slaattnes/Biosignal-DAQ/biosignal-daq-v1.0-bottom.png

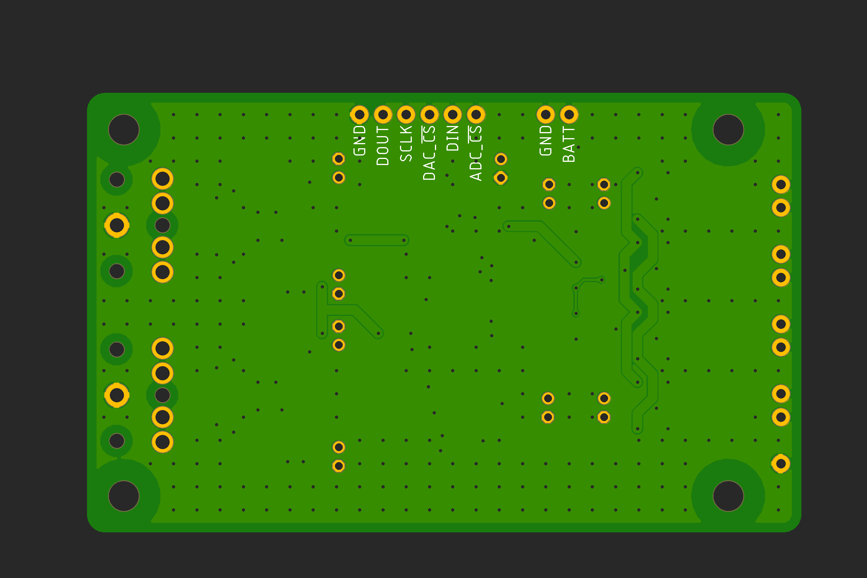
biosignal-daq-v1.0-bottom.png
