slaattnes/Biosignal-DAQ/biosignal-daq-v1.0-top.png

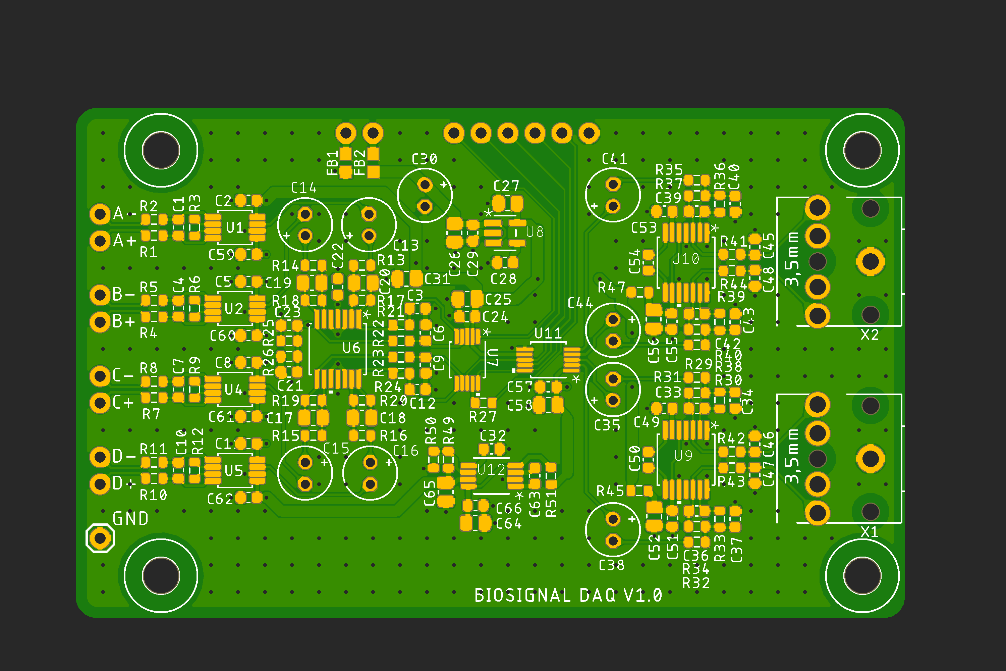
biosignal-daq-v1.0-top.png
