slaattnes/Biosignal-DAQ/biosignal-daq-v1.0-bom.xlsx

Qty | Value | Device | Package | Parts | MANUFACTURER_PART_NUMBER | RATING | TECHNOLOGY | TOLERANCE | VENDOR
10 | 10N | C0603 | CAPC160X80X91L36N | C1, C3, C4, C6, C7, C9, C10, C12, C28, C29 | MC0603B103K101CT | 100 V | X7R | 10% | Multicomp
9 | 100U | CPOL-EUE2-5 | E2-5 | C13, C14, C15, C16, C30, C35, C38, C41, C44 | UKW1C101MDD | 16 V |  | 20% | Nichicon
4 | 47N | C0805 | CAPC200X125X80L50N | C17, C18, C19, C20 | C0805C473K3GAC7800 | 25 V | C0G | 10% | KEMET
11 | 100N | C0603 | CAPC160X80X91L36N | C2, C5, C8, C11, C22, C24, C57, C59, C60, C61, C62 | MC0603B104K100CT | 10V | X7R | 10% | Multicomp
11 | 1U | C0603 | CAPC160X80X91L36N | C21, C23, C32, C49, C50, C51, C53, C54, C55, C63, C66 | 885012106010 | 10 V | X5R | 20% | Würth
9 | 10U | C0805 | CAPC200X125X80L50N | C25, C26, C27, C31, C52, C56, C58, C64, C65 | MCTT21X106M6R3CT | 6.3 V | X5R | 20% | Multicomp
4 | 100P | C0603 | CAPC160X80X91L36N | C33, C36, C39, C42 | MC0603N101J101CT | 100 V | C0G | 5% | Multicomp
4 | 560P | C0603 | CAPC160X80X91L36N | C34, C37, C40, C43 | 0603N561J500CT | 50 V | C0G | 5% | Walsin
4 | 33P | C0603 | CAPC160X80X91L36N | C45, C46, C47, C48 | 0603N330J250CT | 25 V | C0G | 5% | Walsin
2 | 30Œ©/1.8A | FERRITE_BEAD-0603 | 603 | FB1, FB2 | BLM18AG102SN1D |  |  |  | Murata
8 | 4K7 | R0603 | RESC160X80X55L25N | R1, R2, R4, R5, R7, R8, R10, R11 | MCWR06X4701FTL | 100mW |  | 1% | Multicomp
8 | 20K | R0603 | RESC160X80X55L25N | R13, R14, R15, R16, R29, R32, R35, R38 | MCWR06X2002FTL | 100 mW |  | 1% | Multicomp
4 | 360K | R0603 | RESC160X80X55L25N | R17, R18, R19, R20 | MCWR06X3603FTL | 100 mW |  | 1% | Multicomp
4 | 200R | R0603 | RESC160X80X55L25N | R21, R22, R23, R24 | MCWR06X2000FTL | 100 mW |  | 1% | Multicomp
4 | 200K | R0603 | RESC160X80X55L25N | R25, R26, R49, R50 | MCMR06X2003FTL | 100 mW |  | 1% | Multicomp
5 | 47R | R0603 | RESC160X80X55L25N | R27, R41, R42, R43, R44 | MCWR06X47R0FTL | 100 mW |  | 1% | Multicomp
4 | 24K | R0603 | RESC160X80X55L25N | R3, R6, R9, R12 | MCWR06X2402FTL | 100 mW |  | 1% | Multicomp
4 | 5K49 | R0603 | RESC160X80X55L25N | R30, R33, R36, R39 | MCMR06X5491FTL | 100 mW |  | 1% | Multicomp
4 | 28K | R0603 | RESC160X80X55L25N | R31, R34, R37, R40 | MCMR06X2802FTL | 100 mW |  | 1% | Multicomp
3 | 4R7 | R0603 | RESC160X80X55L25N | R45, R47, R51 | MCWR06W4R70FTL | 100 mW |  | 1% | Multicomp
4 | AD8226 | AD8226 | SOP8P65_300X490X95L60X32N | U1, U2, U4, U5 | AD8226ARMZ |  |  |  | Analog Devices
1 | DAC124S085_DGS_10 | DAC124S085_DGS_10 | MUB10A | U11 | DAC124S085_DGS_10 |  |  |  | Texas Instruments
1 | LM2687MM | LM2687MM | MUA08A | U12 | LM2687MM |  |  |  | Texas Instruments
1 | OPA4314 | OPA4314 | PW14 | U6 | OPA4314AIPWR |  |  |  | Texas Instruments
1 | ADC124S021CIMM | ADC124S021CIMM | MUB10A | U7 | ADC124S021CIMM |  |  |  | Texas Instruments
1 | LP2985-33DBVR | LP2985-33DBVR | DBV5 | U8 | LP298533DBVR |  |  |  | Texas Instruments
2 | DRV632PWR | DRV632PWR | PW14 | U9, U10 | DRV632PWR |  |  |  | Texas Instruments
2 | STEREOJACK | STEREOJACK | STX3100 | X1, X2 | SJ1-3555NG |  |  |  | CUI
129
