slaattnes/Biosignal-DAQ/biosignal-daq-v1.0-seeedfusion-bom.xlsx

Designator | MPN/Seeed SKU | Qty | Link
C1, C3, C4, C6, C7, C9, C10, C12, C28, C29 | 0603B103K101CT | 10 | http://file.elecfans.com/web1/M00/85/45/o4YBAFxuX5eAOrDGABKuxiKjpIQ835.pdf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
C17, C18, C19, C20 | C0805C473K3GAC7800 | 4 | https://www.mouser.se/ProductDetail/KEMET/C0805C473K3GAC7800?qs=5BlHYZRUXHFWU0inEjwM1Q==
C2, C5, C8, C11, C22, C24, C57, C59, C60, C61, C62 | 0603B104K160CT | 11 | http://file.elecfans.com/web1/M00/85/45/o4YBAFxuX5eAOrDGABKuxiKjpIQ835.pdf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
C21, C23, C32, C49, C50, C51, C53, C54, C55, C63, C66 | CL10B105KP8NNNC | 11 | http://file.elecfans.com/web1/M00/5C/4C/o4YBAFt04FWAbe4gAAKwH_HJHDI122.pdf
C25, C26, C27, C31, C52, C56, C58, C64, C65 | CL21B106KQQNNNE | 9 | http://www.samsungsem.com/kr/front/downloadcms.do?fileName=C_CL21B106KQQNNNE.pdf
C33, C36, C39, C42 | MC0603N101J101CT | 4 | https://uk.farnell.com/multicomp/mc0603n101j101ct/cap-mlcc-c0g-np0-100pf-100v-0603/dp/1759130
C34, C37, C40, C43 | 0603N561J500CT | 4 | https://www.digikey.com/product-detail/en/walsin-technology-corporation/0603N561J500CT/1292-1536-1-ND/9355540
C45, C46, C47, C48 | 0603N330J250CT | 4 | https://uk.farnell.com/walsin/0603n330j250ct/cap-33pf-25v-5-c0g-np0-0603-reel/dp/2521562
FB1, FB2 | BLM18AG102SN1D | 2 | https://www.digikey.com/product-detail/en/murata-electronics-north-america/BLM18AG102SN1D/490-1015-1-ND/584463
R1, R2, R4, R5, R7, R8, R10, R11 | PTFR0603B4K70P9 | 8 | http://file.elecfans.com/web1/M00/85/7D/o4YBAFxzUSqAb9xOABYkQrSS0nk266.pdf?filename=PTFR.pdf
R13, R14, R15, R16, R29, R32, R35, R38 | RC0603FR-0720KL | 8 | http://www.yageo.com.tw/exep/pages/download/literatures/PYu-R_INT-thick_7.pdf
R17, R18, R19, R20 | RC0603FR-07360KL | 4 | http://www.yageo.com/documents/recent/PYu-RC0603_51_RoHS_L_4.pdf
R21, R22, R23, R24 | PTFR0603B200RP9 | 4 | http://file.elecfans.com/web1/M00/85/7D/o4YBAFxzUSqAb9xOABYkQrSS0nk266.pdf?filename=PTFR.pdf
R25, R26, R49, R50 | PTFR0603B200KP9 | 4 | http://file.elecfans.com/web1/M00/85/7D/o4YBAFxzUSqAb9xOABYkQrSS0nk266.pdf?filename=PTFR.pdf
R27, R41, R42, R43, R44 | PTFR0603B47R0P9 | 5 | http://file.elecfans.com/web1/M00/85/7D/o4YBAFxzUSqAb9xOABYkQrSS0nk266.pdf?filename=PTFR.pdf
R3, R6, R9, R12 | RC0603FR-0724KL | 4 | http://www.yageo.com/documents/recent/PYu-RC0603_51_RoHS_L_4.pdf
R30, R33, R36, R39 | RC0603FR-075K49L | 4 | http://www.yageo.com/documents/recent/PYu-RC0603_51_RoHS_L_4.pdf
R31, R34, R37, R40 | 0603WAF2802T5E | 4 | http://file.elecfans.com/web1/M00/61/0C/o4YBAFt-dwWACUP4AAh1Wgzv73Y460.pdf
R45, R47, R51 | RC0603FR-074R7L | 3 | http://www.yageo.com/documents/recent/PYu-RC_Group_51_RoHS_L_9.pdf
U1, U2, U4, U5 | AD8226ARMZ | 4 | https://www.mouser.se/ProductDetail/Analog-Devices/AD8226ARMZ?qs=%2FtpEQrCGXCzt4qnwBCHKiA==
U11 | DAC124S085CIMM | 1 | https://www.mouser.se/ProductDetail/Texas-Instruments/DAC124S085CIMM-NOPB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
U12 | LM2687MM | 1 | https://www.mouser.se/ProductDetail/Texas-Instruments/LM2687MM-NOPB?qs=X1J7HmVL2ZEsc0DgTZ3C6g==
U6 | OPA4314AIPWR | 1 | https://www.mouser.se/ProductDetail/Texas-Instruments/OPA4314AIPWR?qs=2UFnnMkojnUj9oGVDYRMzw==
U7 | ADC124S021CIMM | 1 | https://www.mouser.se/ProductDetail/Texas-Instruments/ADC124S021CIMM-NOPB?qs=7X5t%252BdzoRHCsOQY55StpJg==
U8 | LP298533DBVR | 1 | https://www.mouser.se/ProductDetail/Texas-Instruments/LP2985-33DBVR
U9, U10 | DRV632PWR | 2 | https://www.mouser.se/ProductDetail/Texas-Instruments/DRV632PWR?qs=TeC8nwD7mVrHDYJBV6Ovjg==
