slaattnes/Biosignal-DAQ/biosignal-daq-v1.0-assembly-bottom.pdf

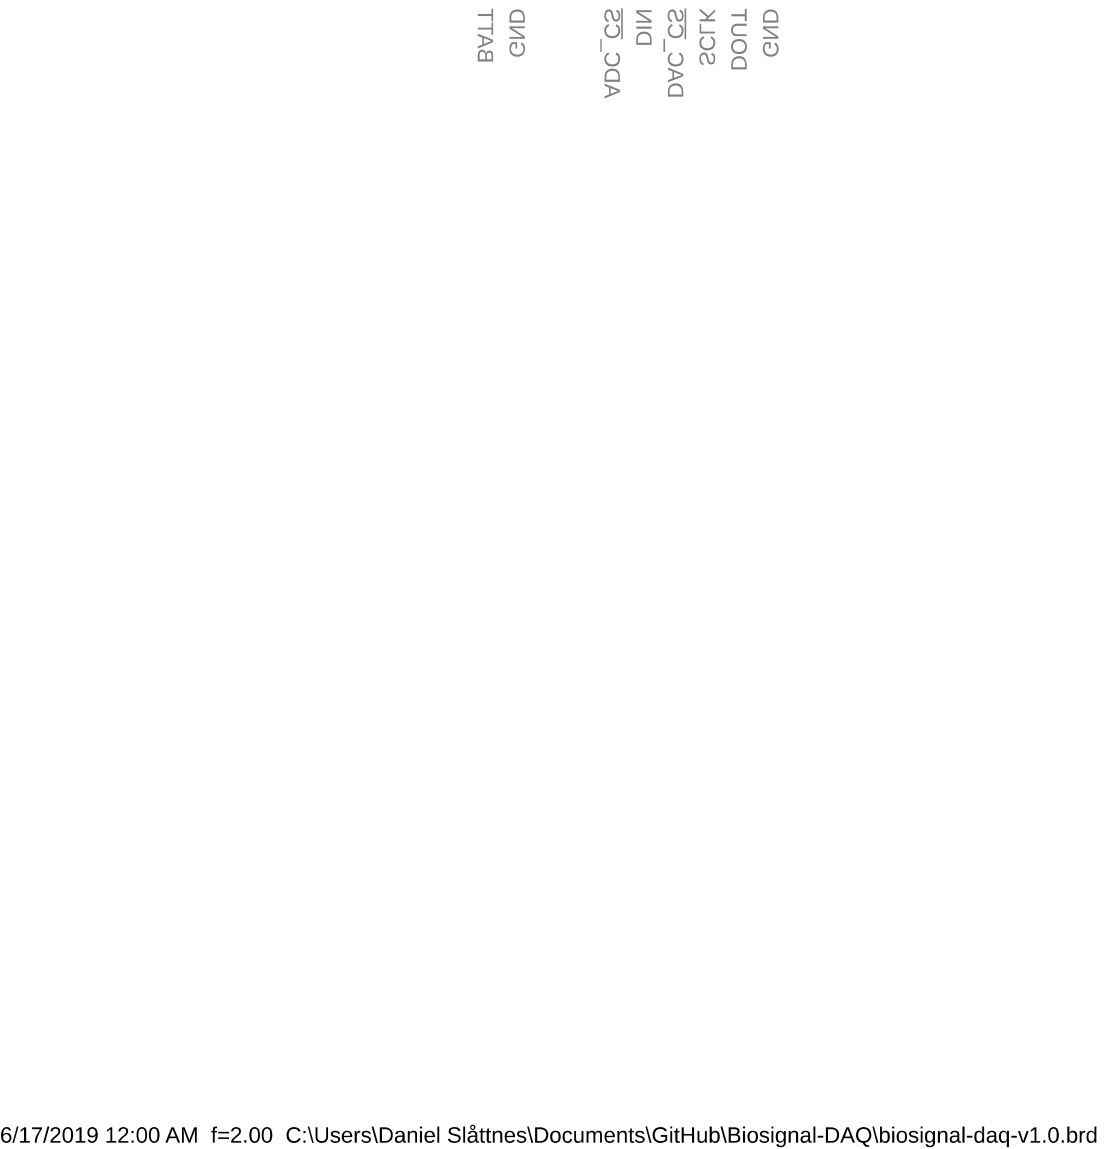
[picture p3: page 1]
