slaattnes/Biosignal-DAQ/biosignal-daq-v1.0-assembly-top.pdf

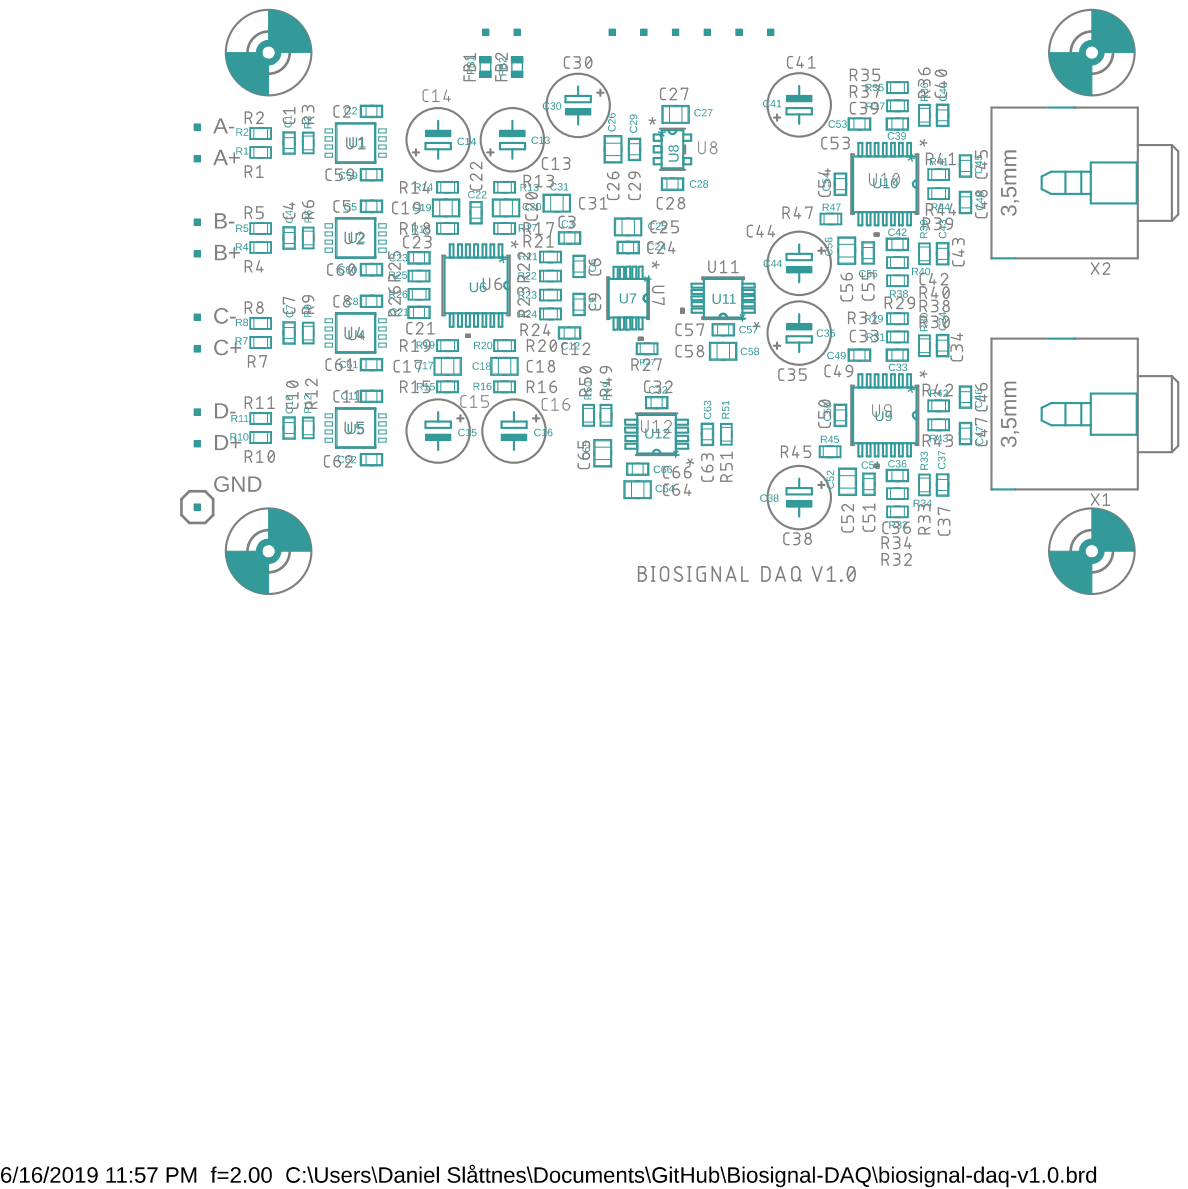
[picture p4: page 1]
