slaattnes/Biosignal-DAQ/biosignal-daq-v1.0.pdf

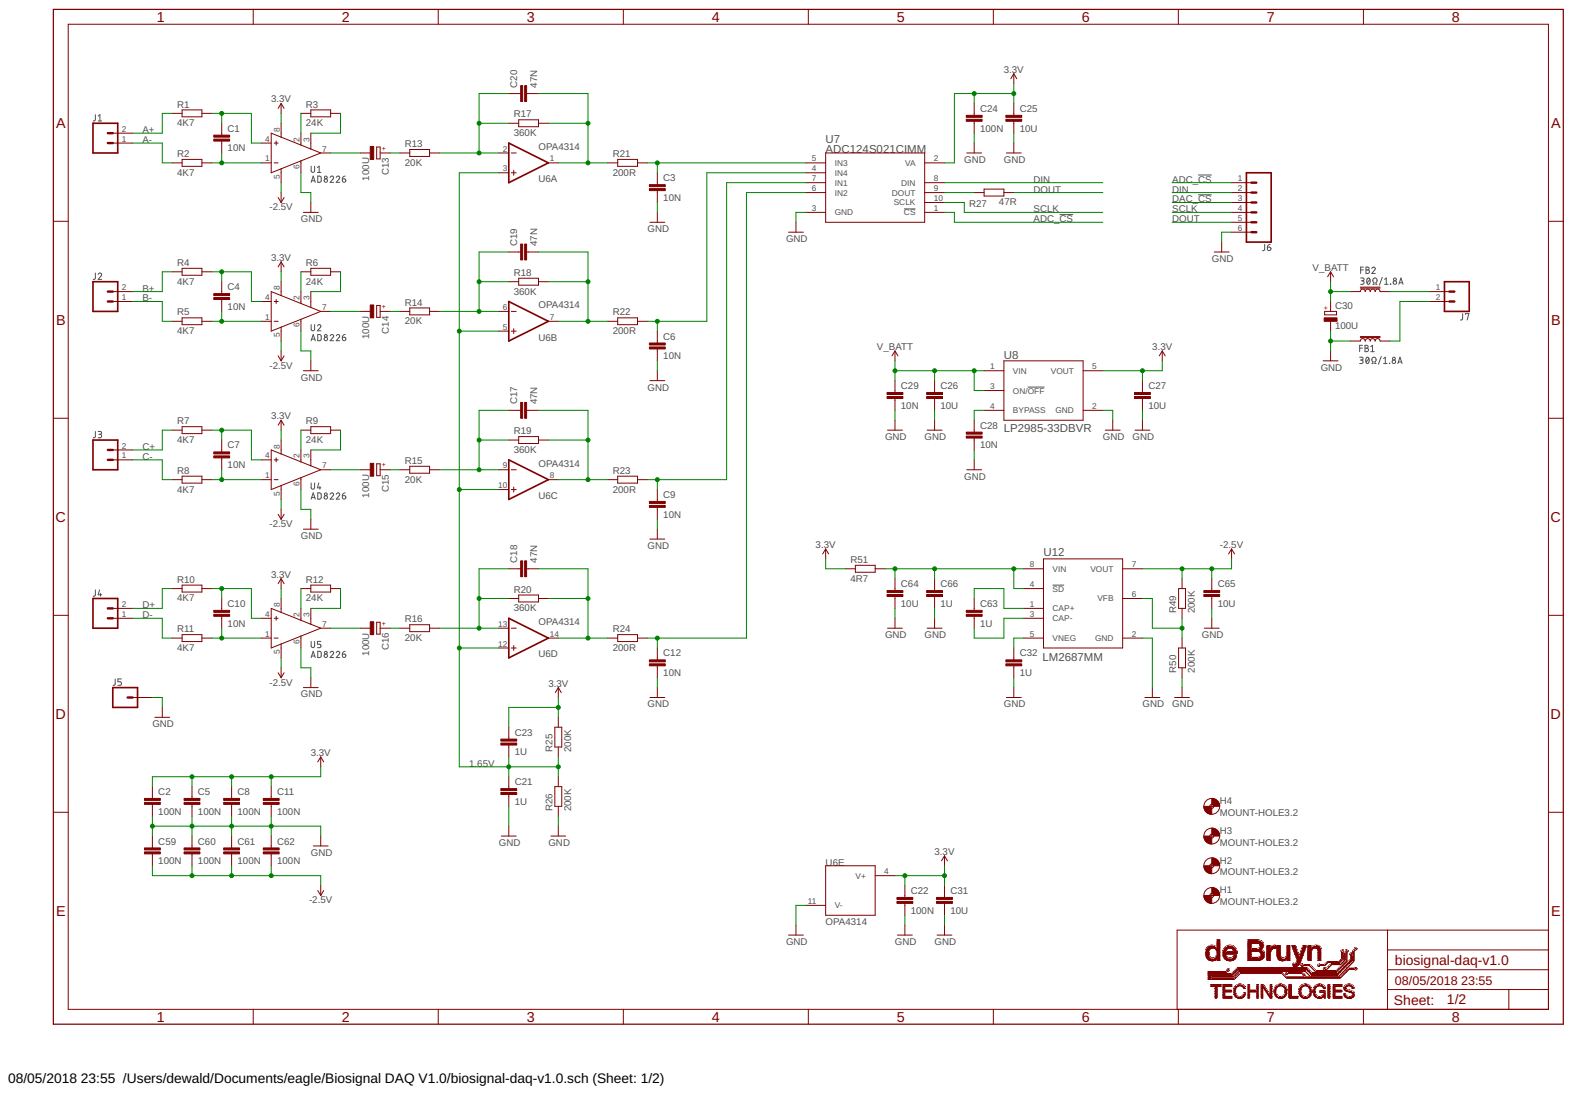
[picture p5: page 1]

08/05/2018 23:55 /Users/dewald/Documents/eagle/Biosignal DAQ V1.0/biosignal-daq-v1.0.sch (Sheet: 1/2)

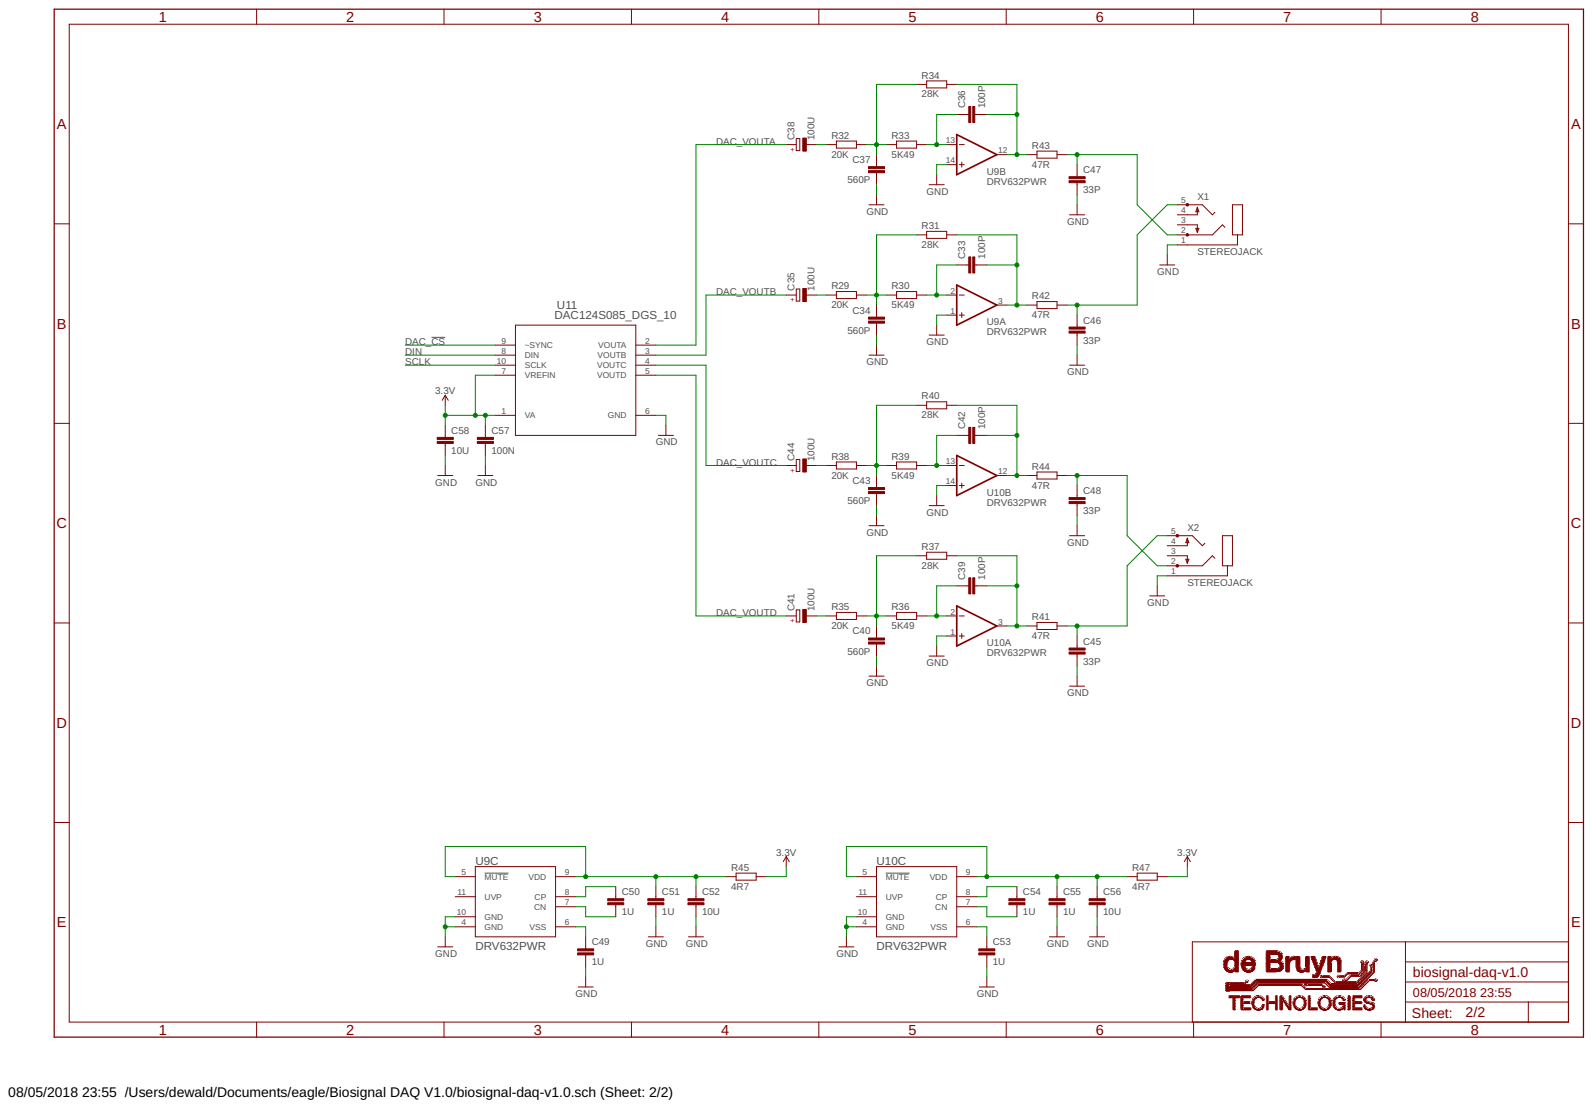
[picture p6: page 2]

08/05/2018 23:55 /Users/dewald/Documents/eagle/Biosignal DAQ V1.0/biosignal-daq-v1.0.sch (Sheet: 2/2)
