slaattnes/Biosignal-DAQ/biosignal-daq-v1.0.brd

## EAGLE design biosignal-daq-v1.0.brd (2018-05-09)

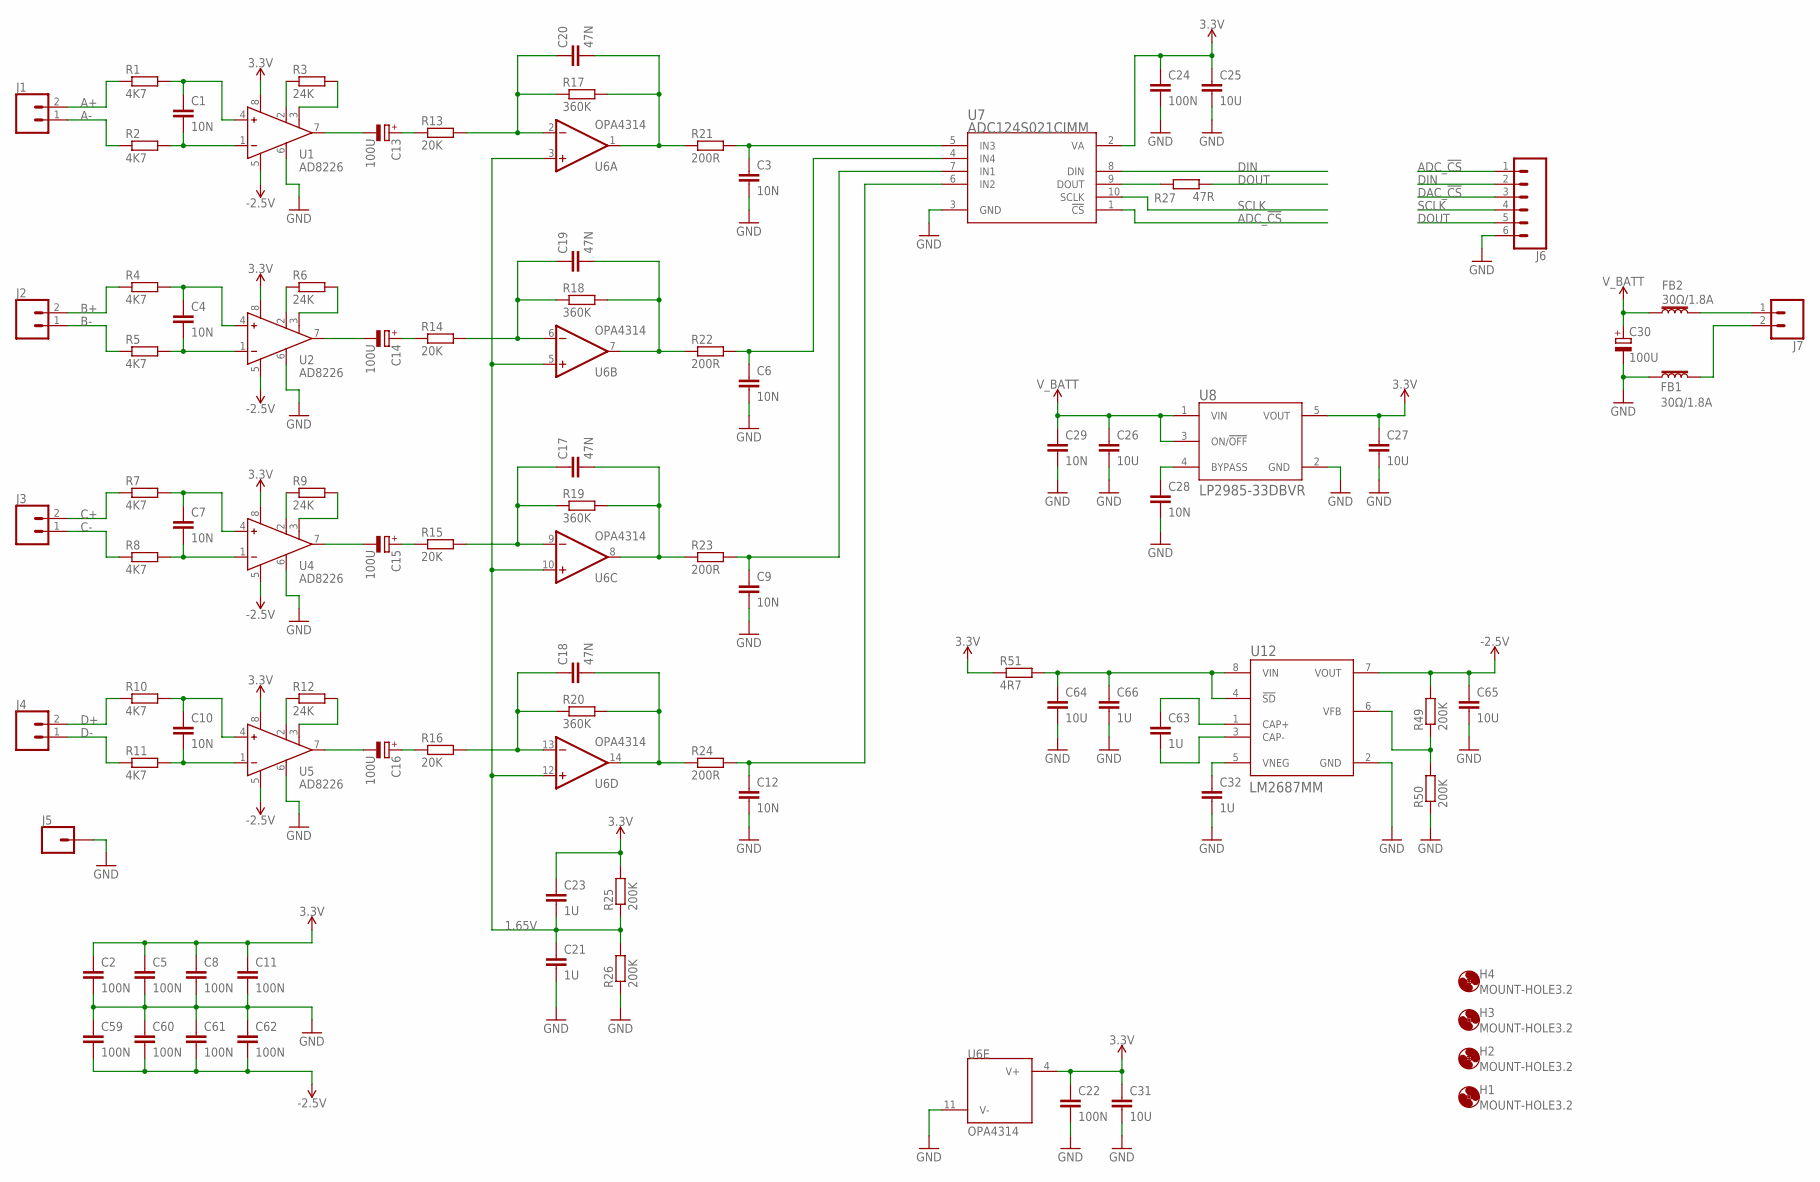
[picture p7: schematic biosignal-daq-v1.0.sch, sheet 1]

Parts:
C1, C3, C4, C6, C7, C9, C10, C12, C28, C29: 10N; CAPC160X80X91L36N
C2, C5, C8, C11, C22, C24, C59, C60, C61, C62: 100N; CAPC160X80X91L36N; RATING 10V; TOLERANCE 10%; MANUFACTURER_PART_NUMBER MC0603B104K100CT
C13, C14, C15, C16, C30: 100U; E2-5
C17, C18, C19, C20: 47N; CAPC200X125X80L50N
C21, C23, C32, C63, C66: 1U; CAPC160X80X91L36N
C25, C26, C27, C31, C64, C65: 10U; CAPC200X125X80L50N
FB1, FB2: 30Ω/1.8A; 0603
H1, H2, H3, H4: MOUNT-HOLE3.2; 3,2
J1, J2, J3, J4, J7: CONN_021X02_NO_SILK; 1X02_NO_SILK
J5: CONN_01; 1X01
J6: CONN_06NO_SILK_NO_POP; 1X06_NO_SILK
R1, R2, R4: 4K7; RESC160X80X55L25N; RATING 100mW; TOLERANCE 1%
R3: 24K; RESC160X80X55L25N; RATING 100mW; TOLERANCE 1%
R5, R7, R8, R10, R11: 4K7; RESC160X80X55L25N
R6, R9, R12: 24K; RESC160X80X55L25N
R13, R14, R15, R16: 20K; RESC160X80X55L25N
R17, R18, R19, R20: 360K; RESC160X80X55L25N
R21, R22, R23, R24: 200R; RESC160X80X55L25N
R25, R26, R49, R50: 200K; RESC160X80X55L25N
R27: 47R; RESC160X80X55L25N
R51: 4R7; RESC160X80X55L25N
U1, U2, U4, U5: AD8226; SOP8P65_300X490X95L60X32N
U6: OPA4314; PW14
U7: ADC124S021CIMM; MUB10A
U8: LP2985-33DBVR; DBV5
U12: LM2687MM; MUA08A

Connections:
1.65V: C21.1, C23.2, R25.1, R26.2, U6.3 (+IN), U6.5 (+IN), U6.10 (+IN), U6.12 (+IN)
3.3V: C2.1, C5.1, C8.1, C11.1, C22.1, C23.1, C24.1, C25.1, C27.1, C31.1, R25.2, R51.1, U1.8 (+VS), U2.8 (+VS), U4.8 (+VS), U5.8 (+VS), U6.4 (V+), U7.2 (VA), U8.5 (VOUT); also elsewhere on the board
-2.5V: C59.2, C60.2, C61.2, C62.2, C65.1, R49.2, U1.5 (-VS), U2.5 (-VS), U4.5 (-VS), U5.5 (-VS), U12.7 (VOUT)
A+: J1.2, R1.1
A-: J1.1, R2.1
ADC_!CS: J6.1, U7.1 (!CS)
B+: J2.2, R4.1
B-: J2.1, R5.1
C+: J3.2, R7.1
C-: J3.1, R8.1
D+: J4.2, R10.1
D-: J4.1, R11.1
DAC_!CS: J6.3; also elsewhere on the board
DIN: J6.2, U7.8 (DIN); also elsewhere on the board
DOUT: J6.5, R27.2
GND: C2.2, C3.2, C5.2, C6.2, C8.2, C9.2, C11.2, C12.2, C21.2, C22.2, C24.2, C25.2, C26.2, C27.2, C28.2, C29.2, C30.-, C31.2, C32.2, C59.1, C60.1, C61.1, C62.1, C64.2, C65.2, C66.2, FB1.1, J5.1, J6.6, R26.1, R50.1, U1.6 (REF), U2.6 (REF), U4.6 (REF), U5.6 (REF), U6.11 (V-), U7.3 (GND), U8.2 (GND), U12.2 (GND); also elsewhere on the board
unnamed: C1.1, R1.2, U1.4 (IN+)
unnamed: C1.2, R2.2, U1.1 (IN-)
unnamed: R3.1, U1.2 (RG)
unnamed: R3.2, U1.3 (RG)
unnamed: C4.1, R4.2, U2.4 (IN+)
unnamed: C4.2, R5.2, U2.1 (IN-)
unnamed: R6.1, U2.2 (RG)
unnamed: R6.2, U2.3 (RG)
unnamed: C7.1, R7.2, U4.4 (IN+)
unnamed: C7.2, R8.2, U4.1 (IN-)
unnamed: R9.1, U4.2 (RG)
unnamed: R9.2, U4.3 (RG)
unnamed: C10.1, R10.2, U5.4 (IN+)
unnamed: C10.2, R11.2, U5.1 (IN-)
unnamed: R12.1, U5.2 (RG)
unnamed: R12.2, U5.3 (RG)
unnamed: C13.-, U1.7 (VOUT)
unnamed: C13.+, R13.1
unnamed: C14.-, U2.7 (VOUT)
unnamed: C14.+, R14.1
unnamed: C15.-, U4.7 (VOUT)
unnamed: C15.+, R15.1
unnamed: C16.-, U5.7 (VOUT)
unnamed: C16.+, R16.1
unnamed: C6.1, R22.2, U7.4 (IN4)
unnamed: C19.1, R14.2, R18.1, U6.6 (-IN)
unnamed: C18.1, R16.2, R20.1, U6.13 (-IN)
unnamed: C18.2, R20.2, R24.1, U6.14 (OUT)
unnamed: C17.1, R15.2, R19.1, U6.9 (-IN)
unnamed: C17.2, R19.2, R23.1, U6.8 (OUT)
unnamed: C19.2, R18.2, R22.1, U6.7 (OUT)
unnamed: C20.1, R13.2, R17.1, U6.2 (-IN)
unnamed: C20.2, R17.2, R21.1, U6.1 (OUT)
unnamed: C9.1, R23.2, U7.7 (IN1)
unnamed: C12.1, R24.2, U7.6 (IN2)
unnamed: C3.1, R21.2, U7.5 (IN3)
unnamed: R27.1, U7.9 (DOUT)
unnamed: FB2.2, J7.1
unnamed: FB1.2, J7.2
unnamed: C28.1, U8.4 (BYPASS)
unnamed: R49.1, R50.2, U12.6 (VFB)
unnamed: C64.1, C66.1, R51.2, U12.4 (!SD), U12.8 (VIN)
unnamed: C63.1, U12.1 (CAP+)
unnamed: C63.2, U12.3 (CAP-)
unnamed: C32.1, U12.5 (VNEG)
SCLK: J6.4, U7.10 (SCLK); also elsewhere on the board
V_BATT: C26.1, C29.1, C30.+, FB2.1, U8.1 (VIN), U8.3 (ON/!OFF)

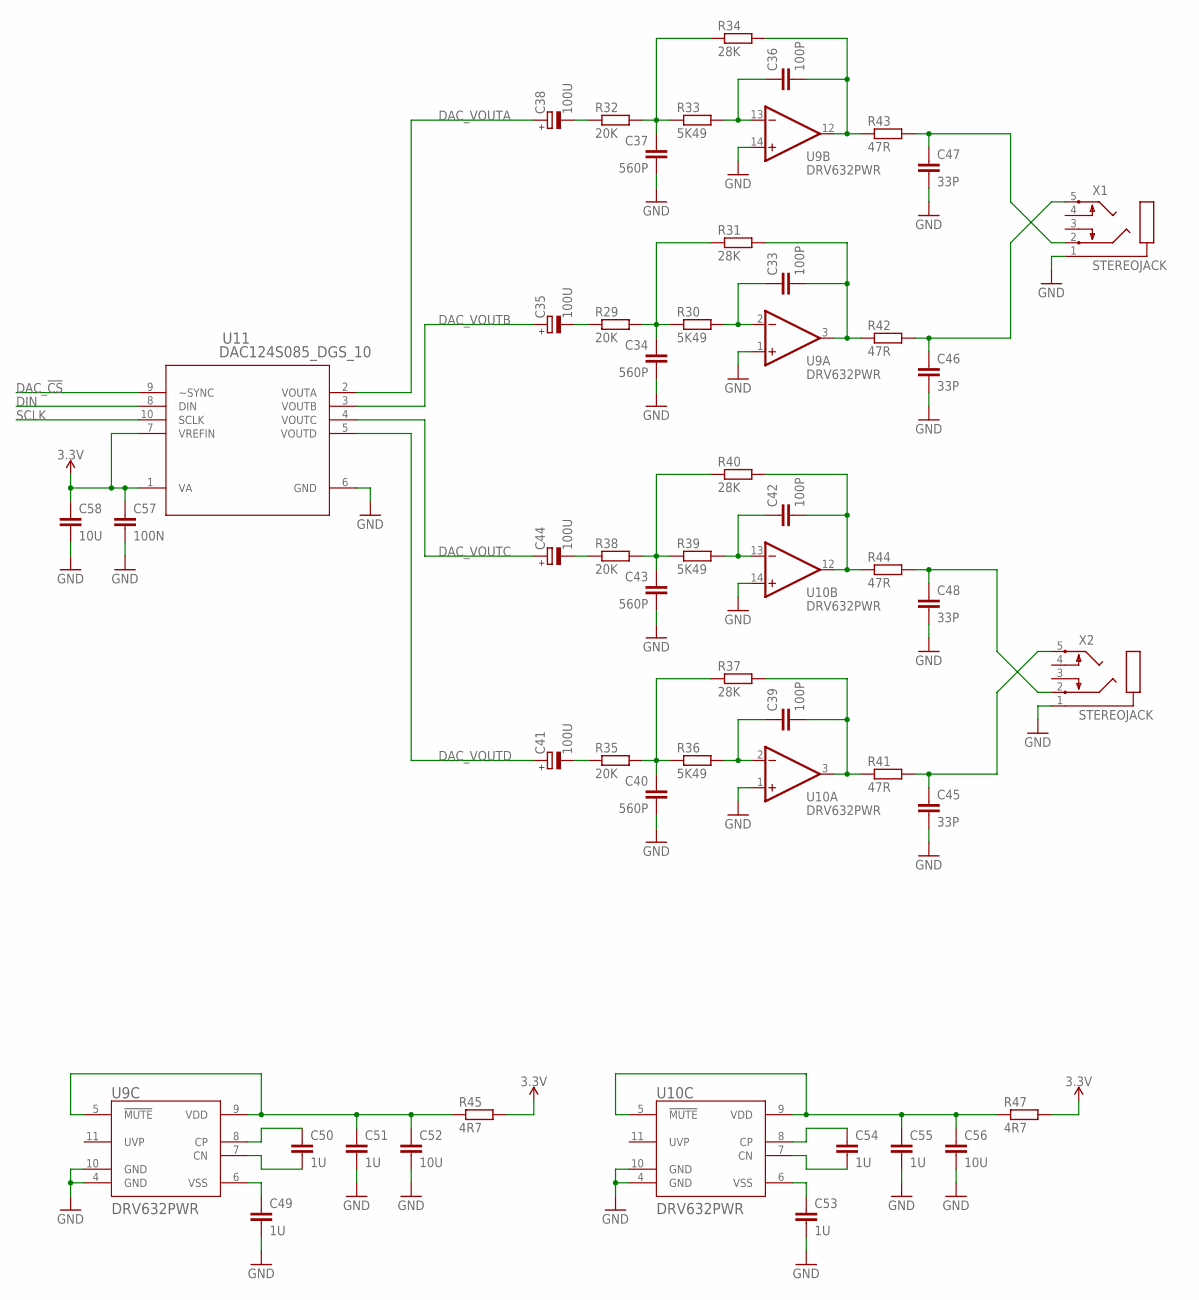
[picture p8: schematic biosignal-daq-v1.0.sch, sheet 2]

Parts:
C33, C36, C39, C42: 100P; CAPC160X80X91L36N
C34, C37, C40, C43: 560P; CAPC160X80X91L36N
C35, C38, C41, C44: 100U; E2-5
C45, C46, C47, C48: 33P; CAPC160X80X91L36N
C49, C50, C51, C53, C54, C55: 1U; CAPC160X80X91L36N
C52, C56, C58: 10U; CAPC200X125X80L50N
C57: 100N; CAPC160X80X91L36N
R29, R32, R35, R38: 20K; RESC160X80X55L25N
R30, R33, R36, R39: 5K49; RESC160X80X55L25N
R31, R34, R37, R40: 28K; RESC160X80X55L25N
R41, R42, R43, R44: 47R; RESC160X80X55L25N
R45, R47: 4R7; RESC160X80X55L25N
U9, U10: DRV632PWR; PW14
U11: DAC124S085_DGS_10; MUB10A
X1, X2: STEREOJACK; STX3100

Connections:
3.3V: C57.1, C58.1, R45.2, R47.2, U11.1 (VA), U11.7 (VREFIN); also elsewhere on the board
DAC_!CS: U11.9 (~SYNC); also elsewhere on the board
DAC_VOUTA: C38.+, U11.2 (VOUTA)
DAC_VOUTB: C35.+, U11.3 (VOUTB)
DAC_VOUTC: C44.+, U11.4 (VOUTC)
DAC_VOUTD: C41.+, U11.5 (VOUTD)
DIN: U11.8 (DIN); also elsewhere on the board
GND: C34.2, C37.2, C40.2, C43.2, C45.2, C46.2, C47.2, C48.2, C49.2, C51.2, C52.2, C53.2, C55.2, C56.2, C57.2, C58.2, U9.1 (+IN), U9.4 (GND), U9.10 (GND), U9.14 (+IN), U10.1 (+IN), U10.4 (GND), U10.10 (GND), U10.14 (+IN), U11.6 (GND), X1.1, X2.1; also elsewhere on the board
unnamed: C47.1, R43.2, X1.2
unnamed: C34.1, R29.2, R30.1, R31.1
unnamed: C33.1, R30.2, U9.2 (-IN)
unnamed: C33.2, R31.2, R42.1, U9.3 (OUT)
unnamed: C35.-, R29.1
unnamed: C37.1, R32.2, R33.1, R34.1
unnamed: C36.1, R33.2, U9.13 (-IN)
unnamed: C36.2, R34.2, R43.1, U9.12 (OUT)
unnamed: C38.-, R32.1
unnamed: C40.1, R35.2, R36.1, R37.1
unnamed: C39.1, R36.2, U10.2 (-IN)
unnamed: C39.2, R37.2, R41.1, U10.3 (OUT)
unnamed: C41.-, R35.1
unnamed: C43.1, R38.2, R39.1, R40.1
unnamed: C42.1, R39.2, U10.13 (-IN)
unnamed: C42.2, R40.2, R44.1, U10.12 (OUT)
unnamed: C44.-, R38.1
unnamed: C45.1, R41.2, X2.5
unnamed: C46.1, R42.2, X1.5
unnamed: C48.1, R44.2, X2.2
unnamed: C50.1, U9.8 (CP)
unnamed: C50.2, U9.7 (CN)
unnamed: C49.1, U9.6 (VSS)
unnamed: C51.1, C52.1, R45.1, U9.5 (!MUTE), U9.9 (VDD)
unnamed: C54.1, U10.8 (CP)
unnamed: C54.2, U10.7 (CN)
unnamed: C53.1, U10.6 (VSS)
unnamed: C55.1, C56.1, R47.1, U10.5 (!MUTE), U10.9 (VDD)
SCLK: U11.10 (SCLK); also elsewhere on the board

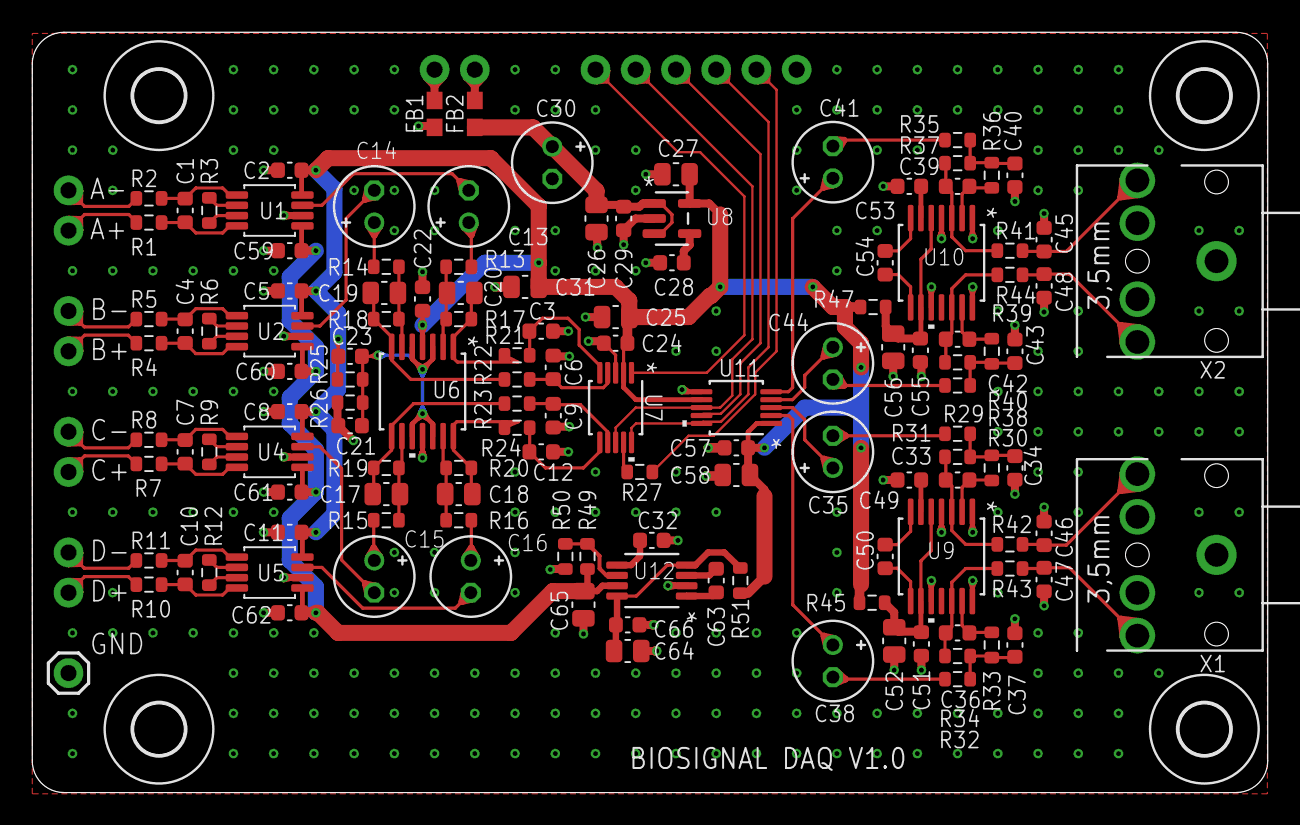
[picture p9: board biosignal-daq-v1.0.brd from above]

Board: 2 copper layers, 78.0 x 48.0 mm, 140 parts (0 on the bottom side), 95 nets.
