slaattnes/Biosignal-DAQ/(threads)

Thread 1 (2018-05-27):

Opposite labels for Battery and Ground at J7

slaattnes, 2018-05-27:
The labels for battery and ground at J7 is labeled wrong. It should be opposite.
